wizhard2006/WordClock_WiZ/hardware/wiring/leds_wiring-diagram_generique.png

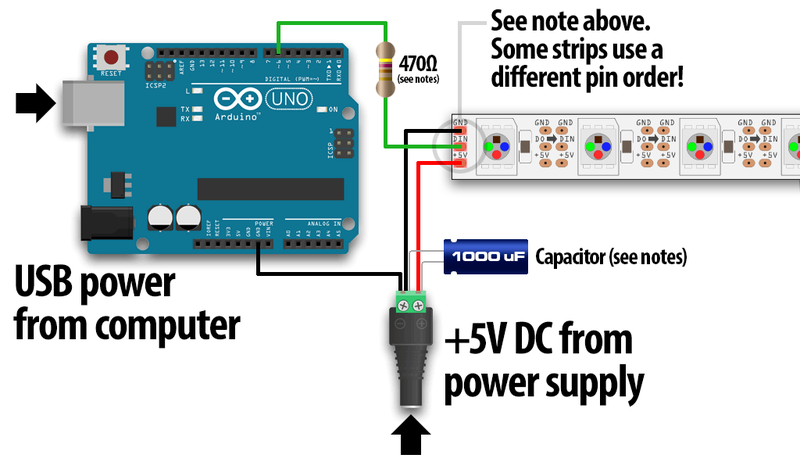
hardware/wiring/leds_wiring-diagram_generique.png
