wizhard2006/WordClock_WiZ/(commit log)

2026-09-07 feat: firmwares ESP8266 et ESP32 corriges, documentation et archive
    [WordClock_code_Lettrine.xlsx]
2026-09-08 feat: memo WebUI, correctif du mot de passe WiFi expose
    [WordClock_ESP32.ino, WordClock_ESP8266.ino]
2026-09-08 feat: generateur JSON OTA v3.0 avec verification de version
2026-09-08 chore: version 2.0.2 pour test de la chaine OTA
